minisystem/840/README.md

SYSTEM80 840
======================================

Voltage controlled ADSR in Eurorack format. Currently under development.

Hardware design by Minisystem: info@system80.net

LICENSE
=======
cc by-nc-sa
https://creativecommons.org/licenses/by-nc-sa/4.0/
