minisystem/840/840-ADSR.kicad_pcb

## KiCad design 840-ADSR.kicad_pcb (2018-11-05)

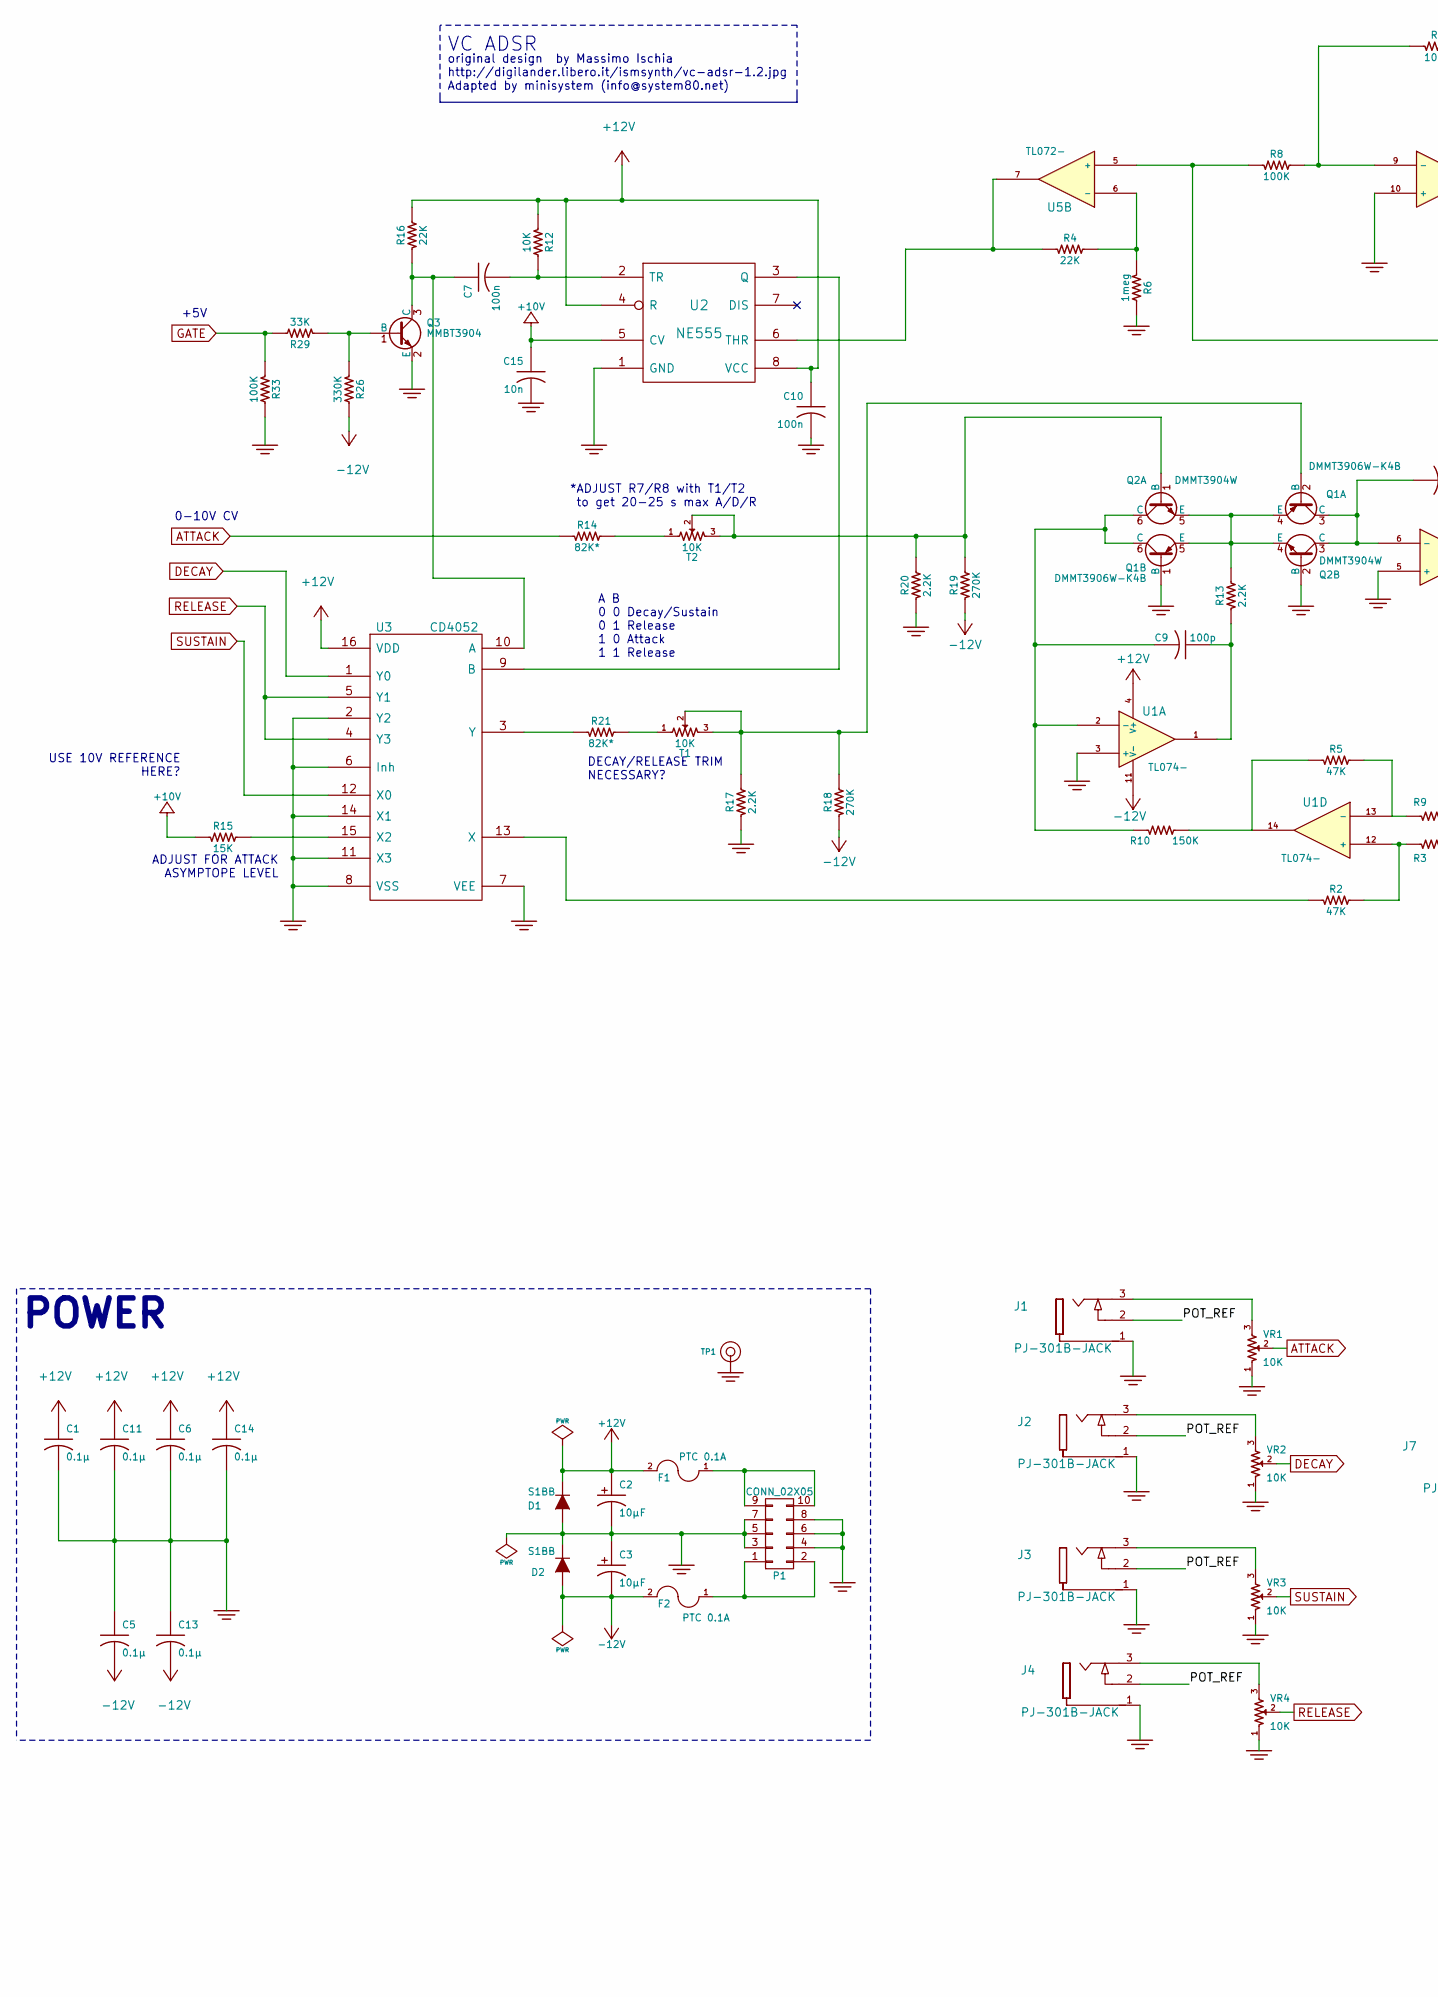
[picture p1: schematic 840-ADSR.sch, part in row 1, column 1]

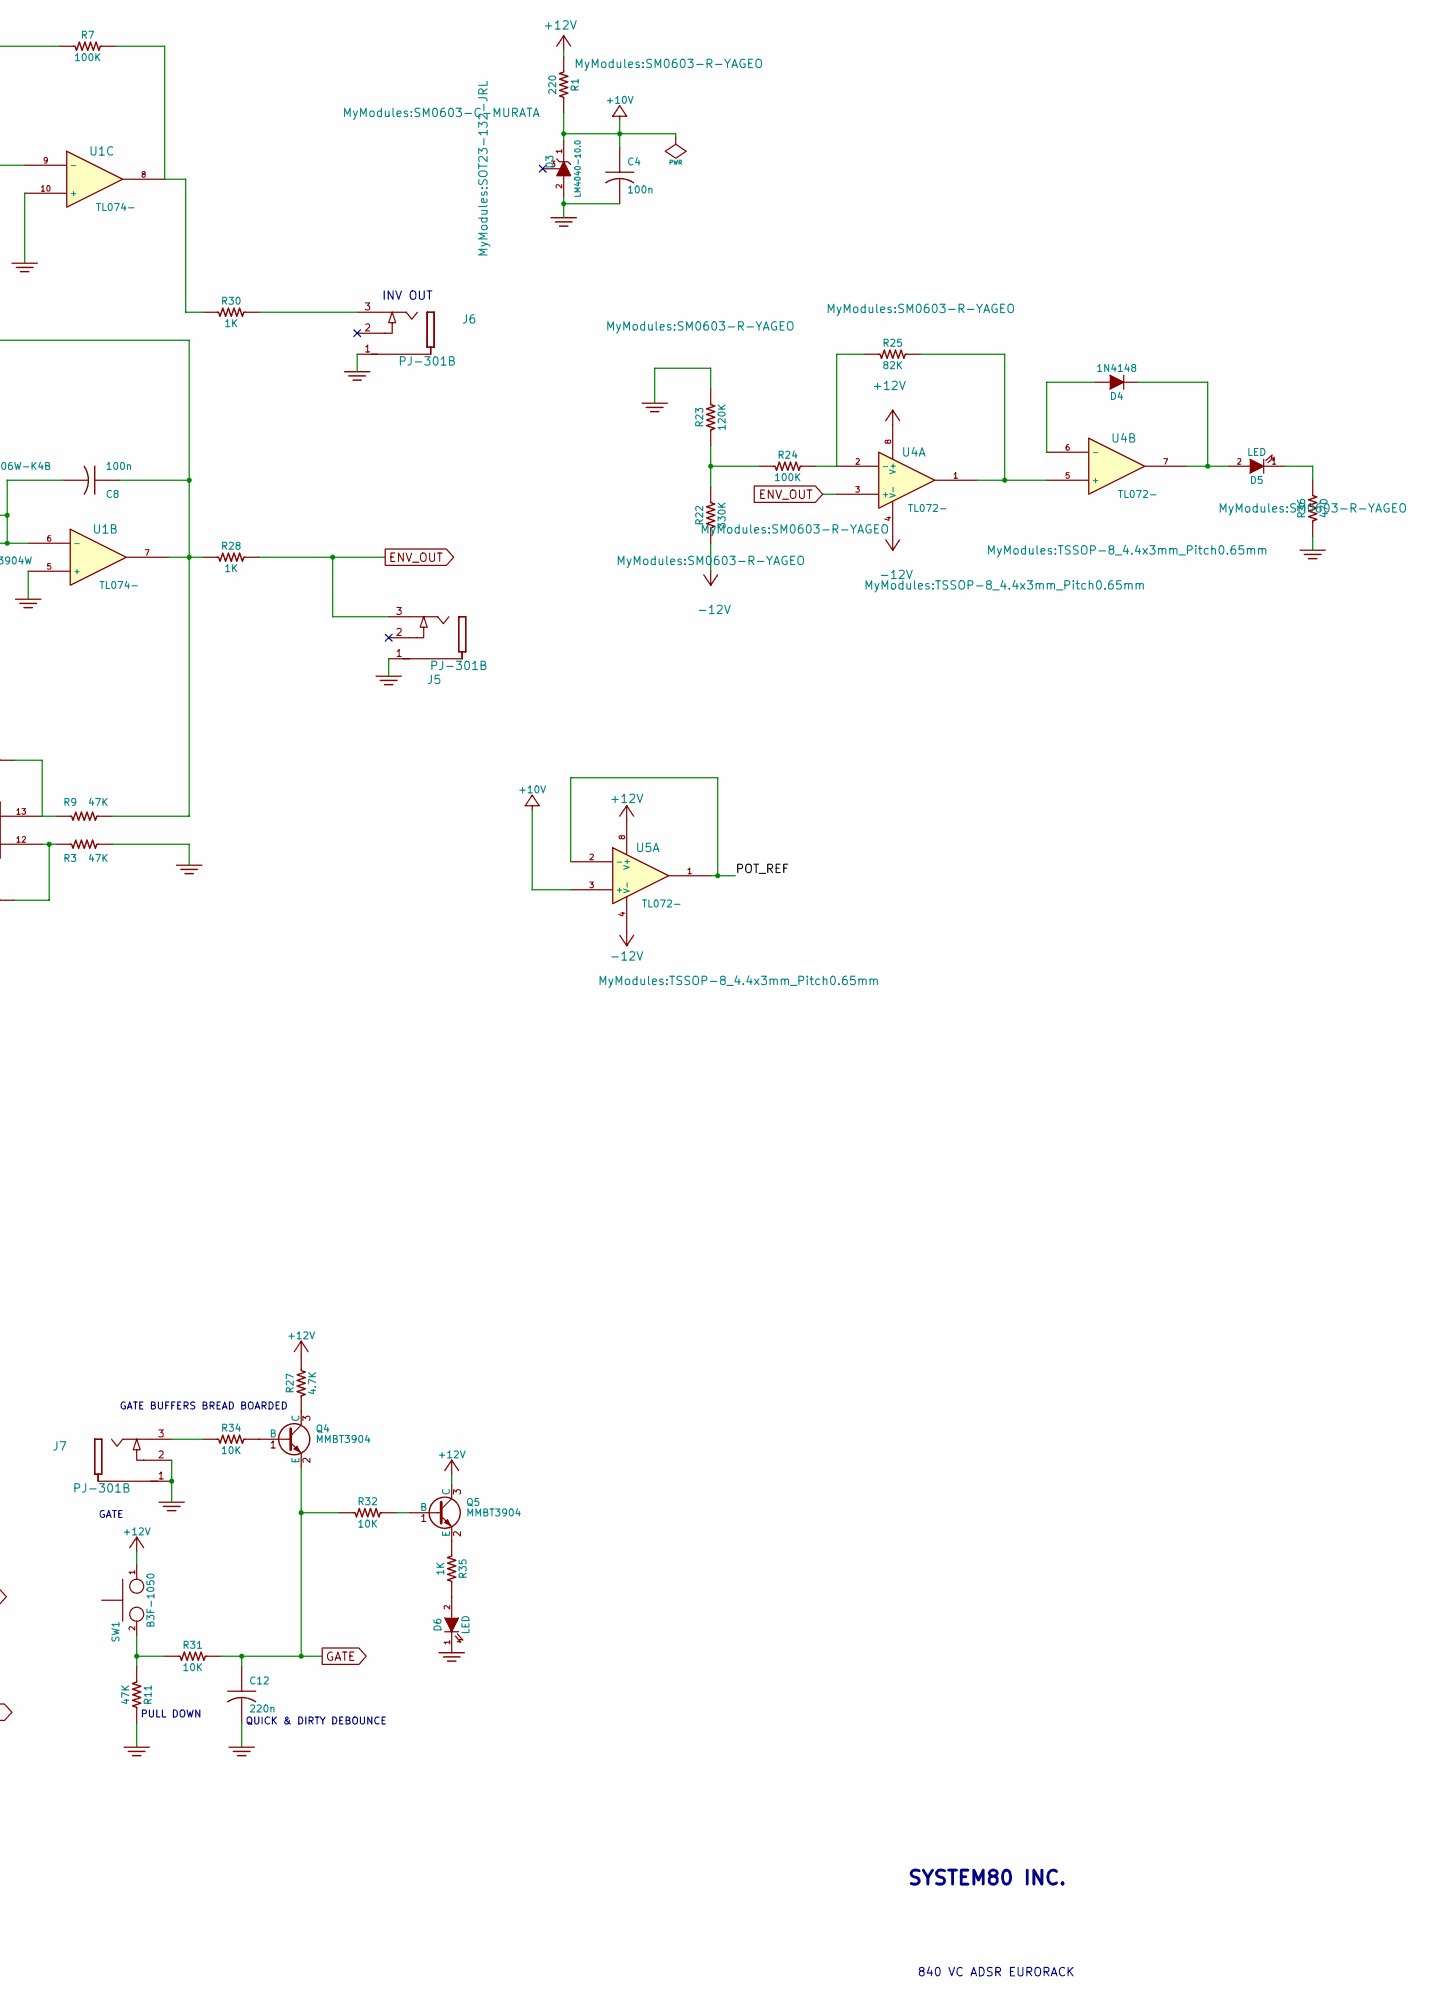
[picture p2: schematic 840-ADSR.sch, part in row 1, column 2]

Parts:
C1, C5, C6, C11, C13, C14: 0.1µ; SM0603-C-MURATA
C2, C3: 10μF; jrl_c_elec_5x5.3
C4, C7, C8, C10: 100n; SM0603-C-MURATA
C9: 100p; SM0603-C-MURATA
C12: 220n; SM0805-HAND
C15: 10n; SM0603-C-MURATA
D1, D2: S1BB; SMB-1C2A
D3: LM4040-10.0; SOT23-132-JRL
D4: 1N4148; SOD323-C1A2
D5, D6: LED; 3MM-LED-C1A2
F1, F2: PTC 0.1A; SM0805-HAND
J1, J2, J3, J4: PJ-301B-JACK; PJ-301B-JACK-SLOTS
J5, J6, J7: PJ-301B; PJ-301B-JACK-SLOTS
P1: CONN_02X05; Pin_Header_Straight_2x05_Pitch2.54mm
Q1: DMMT3906W-K4B; SOT363-JRL
Q2: DMMT3904W; SOT363-JRL
Q3, Q4, Q5: MMBT3904; SOT23-132-JRL
R1: 220; SM0603-R-YAGEO
R2, R3, R5, R9, R11: 47K; SM0603-R-YAGEO
R4, R16: 22K; SM0603-R-YAGEO
R6: 1meg; SM0603-R-YAGEO
R7, R8, R24, R33: 100K; SM0603-R-YAGEO
R10: 150K; SM0603-R-YAGEO
R12, R31, R32, R34: 10K; SM0603-R-YAGEO
R13, R17, R20: 2.2K; SM0603-R-YAGEO
R14, R21: 82K*; SM0603-R-YAGEO
R15: 15K; SM0603-R-YAGEO
R18, R19: 270K; SM0603-R-YAGEO
R22, R26: 330K; SM0603-R-YAGEO
R23: 120K; SM0603-R-YAGEO
R25: 82K; SM0603-R-YAGEO
R27: 4.7K; SM0603-R-YAGEO
R28, R30, R35: 1K; SM0603-R-YAGEO
R29: 33K; SM0603-R-YAGEO
R36: 470; SM0603-R-YAGEO
SW1: B3F-1050; B3F-1050-OMRON
T1, T2: 10K; TC33X-2
TP1: CONN_1; TEST_POINT_LOOP_4592
U1: TL074-; TSSOP-14_4.4x5mm_Pitch0.65mm
U2: NE555; TSSOP-8_4.4x3mm_Pitch0.65mm
U3: CD4052; TSSOP-16_4.4x5mm_Pitch0.65mm_jrl
U4, U5: TL072-; TSSOP-8_4.4x3mm_Pitch0.65mm
VR1, VR2, VR3, VR4: 10K; RD901F-ALPHA-POT-T18

Connections:
+10V: C4.1, C15.1, D3.1 (K), R1.2, R15.1, U2.5 (CV), U5.3 (+)
+12V: C1.1, C2.1 (+), C6.1, C10.1, C11.1, C14.1, D1.1 (K), F1.2, Q5.3 (C), R1.1, R12.1, R16.2, R27.2, SW1.1, U1.4 (V+), U2.4 (R), U2.8 (VCC), U3.16 (VDD), U4.8 (V+), U5.8 (V+)
-12V: C3.2 (-), C5.2, C13.2, D2.2 (A), F2.2, R18.1, R19.1, R22.1, R26.2, U1.11 (V-), U4.4 (V-), U5.4 (V-)
/POT_REF: J1.2, J2.2, J3.2, J4.2, U5.1, U5.2 (-)
ATTACK: R14.1, VR1.2
DECAY: U3.1 (Y0), VR2.2
ENV_OUT: J5.3, R28.2, U4.3 (+)
GATE: C12.1, Q4.2 (E), R29.2, R31.2, R32.1, R33.1
GND: C1.2, C2.2 (-), C3.1 (+), C4.2, C5.1, C6.2, C10.2, C11.2, C12.2, C13.1, C14.2, C15.2, D1.2 (A), D2.1 (K), D3.2 (A), D6.1 (K), J1.1, J2.1, J3.1, J4.1, J5.1, J6.1, J7.1, J7.2, P1.3, P1.4, P1.5, P1.6, P1.7, P1.8, Q1.1 (B), Q2.2 (B), Q3.2 (E), R3.2, R6.2, R11.2, R17.1, R20.1, R23.2, R33.2, R36.1, TP1.1, U1.3 (+), U1.5 (+), U1.10 (+), U2.1 (GND), U3.2 (Y2), U3.6 (Inh), U3.7 (VEE), U3.8 (VSS), U3.11 (X3), U3.14 (X1), VR1.1, VR2.1, VR3.1, VR4.1
unnamed: C7.1, Q3.3 (C), R16.1, U3.10 (A)
unnamed: C7.2, R12.2, U2.2 (TR)
unnamed: C8.1, R8.1, R9.2, R28.1, U1.7, U5.5 (+)
unnamed: C8.2, Q1.3 (C), Q2.3 (C), U1.6 (-)
unnamed: C9.1, R13.1, U1.1
unnamed: C9.2, Q1.6 (C), Q2.6 (C), R10.1, U1.2 (-)
unnamed: D4.1 (K), D5.2 (A), U4.7
unnamed: D4.2 (A), U4.6 (-)
unnamed: D5.1 (K), R36.2
unnamed: D6.2 (A), R35.2
unnamed: F1.1, P1.9, P1.10
unnamed: F2.1, P1.1, P1.2
unnamed: J1.3, VR1.3
unnamed: J2.3, VR2.3
unnamed: J3.3, VR3.3
unnamed: J4.3, VR4.3
unnamed: J6.3, R30.2
unnamed: J7.3, R34.1
unnamed: Q1.2 (B), R17.2, R18.2, T1.2, T1.3
unnamed: Q1.4 (E), Q1.5 (E), Q2.4 (E), Q2.5 (E), R13.2
unnamed: Q2.1 (B), R19.2, R20.2, T2.2, T2.3
unnamed: Q3.1 (B), R26.1, R29.1
unnamed: Q4.1 (B), R34.2
unnamed: Q4.3 (C), R27.1
unnamed: Q5.1 (B), R32.2
unnamed: Q5.2 (E), R35.1
unnamed: R2.1, U3.13 (X)
unnamed: R2.2, R3.1, U1.12 (+)
unnamed: R4.1, U2.6 (THR), U5.7
unnamed: R4.2, R6.1, U5.6 (-)
unnamed: R5.2, R9.1, U1.13 (-)
unnamed: R7.1, R8.2, U1.9 (-)
unnamed: R5.1, R10.2, U1.14
unnamed: R11.1, R31.1, SW1.2
unnamed: R14.2, T2.1
unnamed: R15.2, U3.15 (X2)
unnamed: R21.1, U3.3 (Y)
unnamed: R21.2, T1.1
unnamed: R22.2, R23.1, R24.1
unnamed: R24.2, R25.1, U4.2 (-)
unnamed: R25.2, U4.1, U4.5 (+)
unnamed: R7.2, R30.1, U1.8
unnamed: U2.3 (Q), U3.9 (B)
RELEASE: U3.4 (Y3), U3.5 (Y1), VR4.2
SUSTAIN: U3.12 (X0), VR3.2

Notes on the sheet:
SYSTEM80 INC.
840 VC ADSR EURORACK
*ADJUST R7/R8 with T1/T2 to get 20-25 s max A/D/R
0-10V CV
+5V
VC ADSR
original design by Massimo Ischia http://digilander.libero.it/ismsynth/vc-adsr-1.2.jpg Adapted by minisystem (info@system80.net)
POWER
GATE
GATE BUFFERS BREAD BOARDED
QUICK & DIRTY DEBOUNCE
INV OUT
A B 0 0 Decay/Sustain 0 1 Release 1 0 Attack 1 1 Release
DECAY/RELEASE TRIM NECESSARY?
PULL DOWN
ADJUST FOR ATTACK ASYMPTOPE LEVEL
USE 10V REFERENCE HERE?

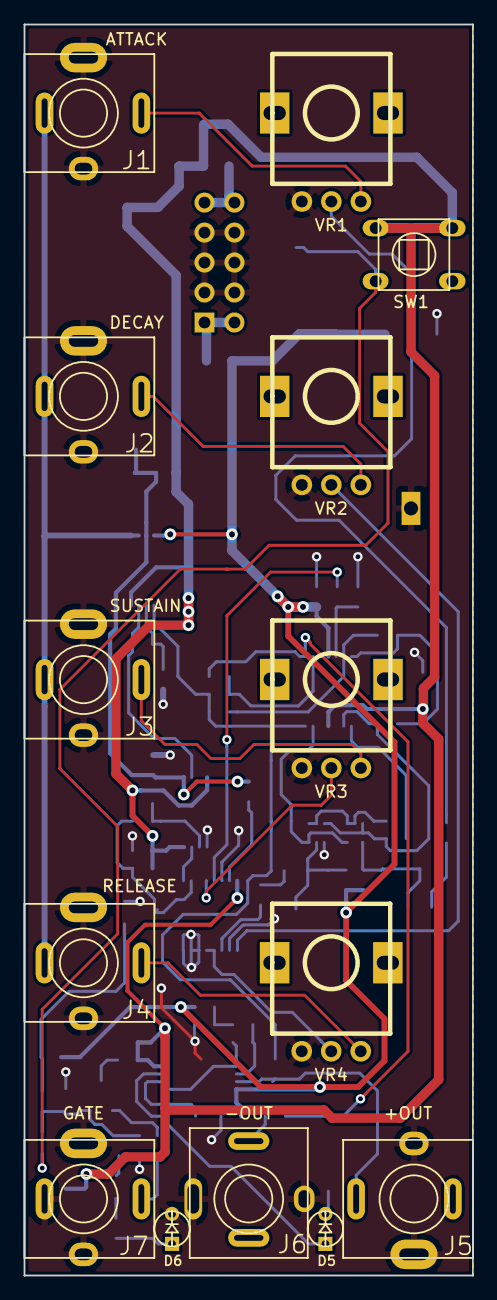
[picture p3: board 840-ADSR.kicad_pcb from above]

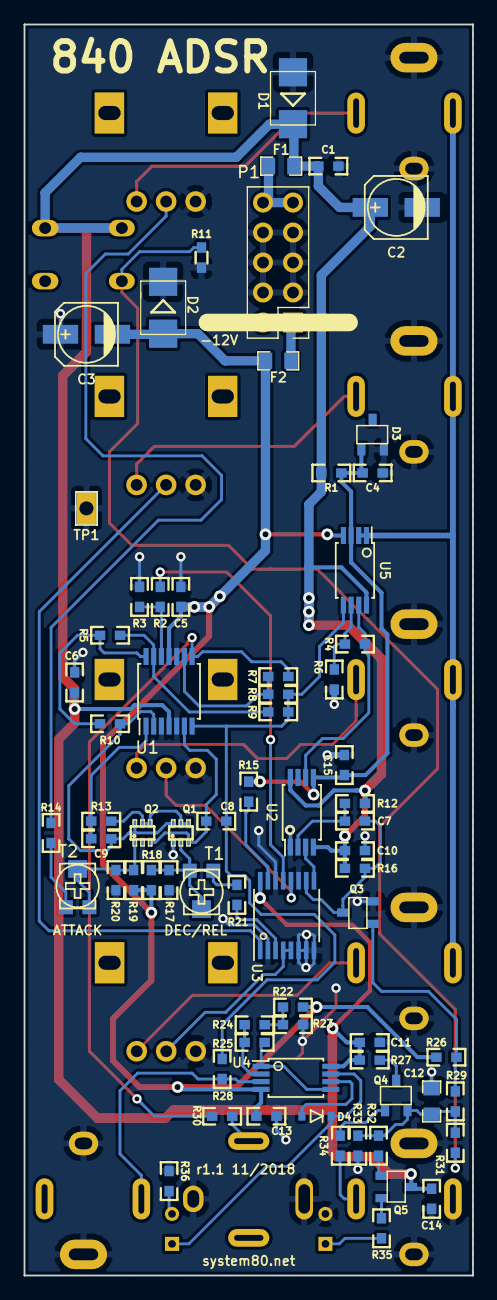
[picture p4: board 840-ADSR.kicad_pcb from below]

Board: 2 copper layers, 38.0 x 106.0 mm, 85 parts (71 on the bottom side), 54 nets.
