minisystem/840/(commit log)

2018-06-19 first commit"
    "
    [840-ADSR.kicad_pcb, 840-ADSR.sch]
2018-06-20 footprints associated, starting placing
    [840-ADSR.sch]
2018-06-23 parts mostly placed, starting to route
    [840-ADSR.kicad_pcb, 840-ADSR.sch]
2018-06-25 almost done routing
    [840-ADSR.kicad_pcb, 840-ADSR.sch]
2018-06-25 routed, need to place silk screen labels
    [840-ADSR.kicad_pcb, 840-ADSR.sch]
2018-06-26 added .gitignore and some silk screen tweaking
    [840-ADSR.kicad_pcb, 840-ADSR.sch]
2018-06-28 bit of rail tweaking
    [840-ADSR.kicad_pcb]
2018-07-18 delted 3.3K resistor connected to 555 CV pin and replaced wtih 10V reference. duh.
    [840-ADSR.kicad_pcb, 840-ADSR.sch]
2018-11-03 prototype built, needs tweaking, about to start
    [840-ADSR.kicad_pcb, 840-ADSR.sch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]
2018-11-05 v1.1 in the works. buffered env output to 555 threshold input, changed 10V reference distribution added some notes
    [840-ADSR.kicad_pcb, 840-ADSR.sch]
